spbnick/washear/washear.sch.png

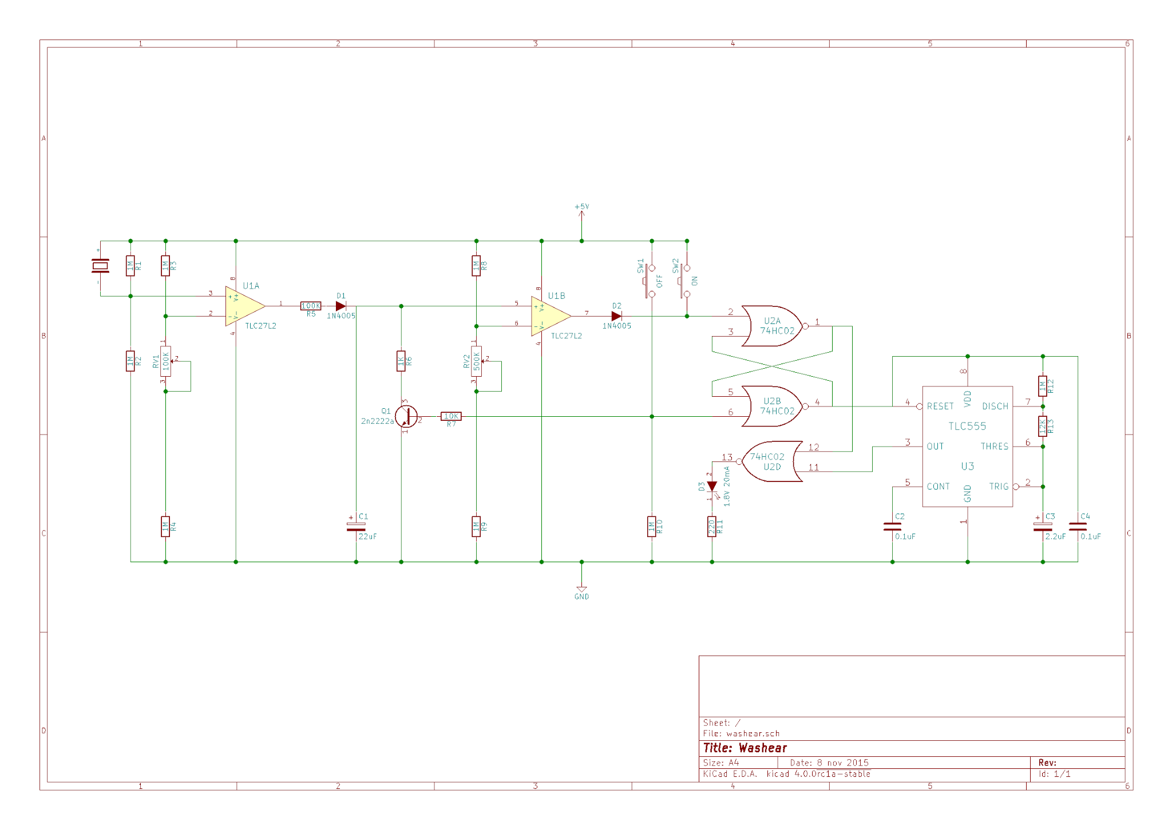
washear.sch.png
