spbnick/washear/washear.sch

## KiCad design washear.sch (2016-01-05)

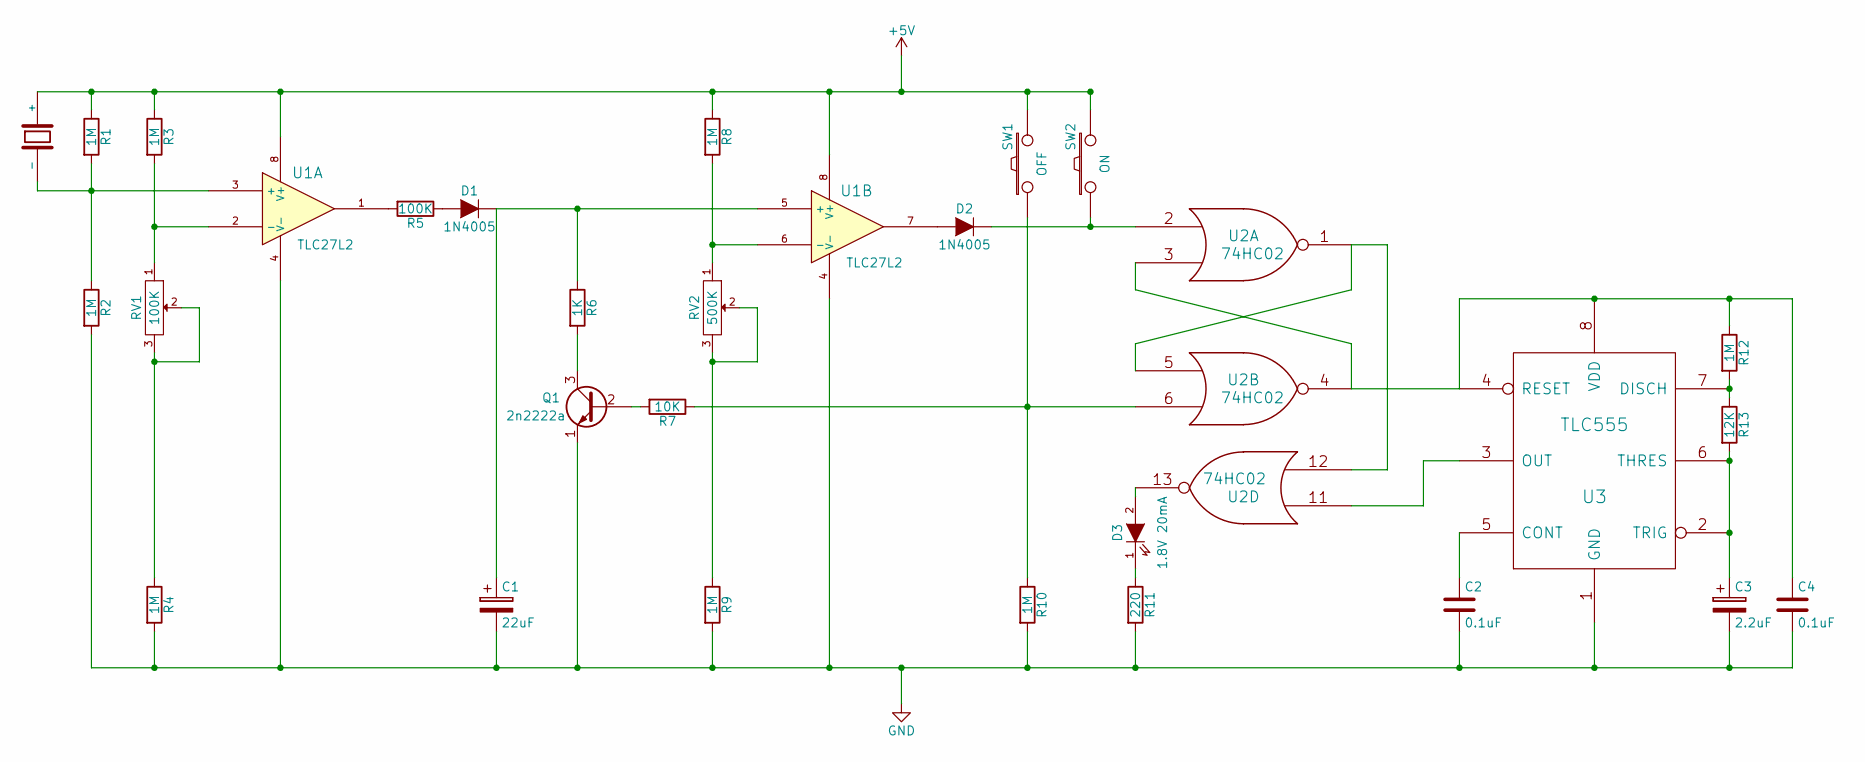
[picture p5: schematic washear.sch]

Parts:
C1: 22uF
C2, C4: 0.1uF
C3: 2.2uF
D1, D2: 1N4005
D3: 1.8V 20mA
PZ1: PZ
Q1: 2n2222a
R1, R2, R3, R4, R8, R9, R10, R12: 1M
R5: 100K
R6: 1K
R7: 10K
R11: 220
R13: 12K
RV1: 100K
RV2: 500K
SW1: OFF
SW2: ON
U1: TLC27L2
U2: 74HC02
U3: TLC555

Connections:
+5V: PZ1.1 (+), R1.1, R3.1, R8.1, SW1.2, SW2.2, U1.8 (V+)
GND: C1.2, C2.2, C3.2, C4.2, Q1.1 (E), R2.2, R4.2, R9.2, R10.2, R11.2, U1.4 (V-), U3.1 (GND)
unnamed: C1.1, D1.1 (K), R6.1, U1.5 (+)
unnamed: C2.1, U3.5 (CONT)
unnamed: C3.1, R13.2, U3.2 (TRIG), U3.6 (THRES)
unnamed: C4.1, R12.1, U2.3, U2.4, U3.4 (RESET), U3.8 (VDD)
unnamed: D1.2 (A), R5.1
unnamed: D2.1 (K), SW2.1, U2.2
unnamed: D2.2 (A), U1.7
unnamed: D3.1 (K), R11.1
unnamed: D3.2 (A), U2.13
unnamed: PZ1.2 (-), R1.2, R2.1, U1.3 (+)
unnamed: Q1.2 (B), R7.2
unnamed: Q1.3 (C), R6.2
unnamed: R3.2, RV1.1, U1.2 (-)
unnamed: R4.1, RV1.2, RV1.3
unnamed: R5.2, U1.1
unnamed: R8.2, RV2.1, U1.6 (-)
unnamed: R9.1, RV2.2, RV2.3
unnamed: R7.1, R10.1, SW1.1, U2.6
unnamed: R12.2, R13.1, U3.7 (DISCH)
unnamed: U2.1, U2.5, U2.12
unnamed: U2.11, U3.3 (OUT)
