spbnick/washear/(commit log)

2015-08-30 Add first incomplete schematics draft
    [washear.sch]
2015-10-24 Complete the draft schematics
    [washear.sch]
2015-12-24 Complete second draft schematics
    [washear.sch]
2015-12-24 Add blinking timer calculation script
2015-12-26 Capture first complete working schematic
    [washear.sch]
2015-12-28 Add cache library as schematic references it automatically
    [washear.sch]
2015-12-28 Align components on the schematic
    [washear.sch]
2015-12-28 Power TLC555 from logic gate to save power
    [washear.sch]
2016-01-05 Capture the final implemented schematic
    [washear.sch]
2019-01-23 Add schematic image
